jbuszkie/diyBMSv4/ModuleV450/export/PCB.pdf

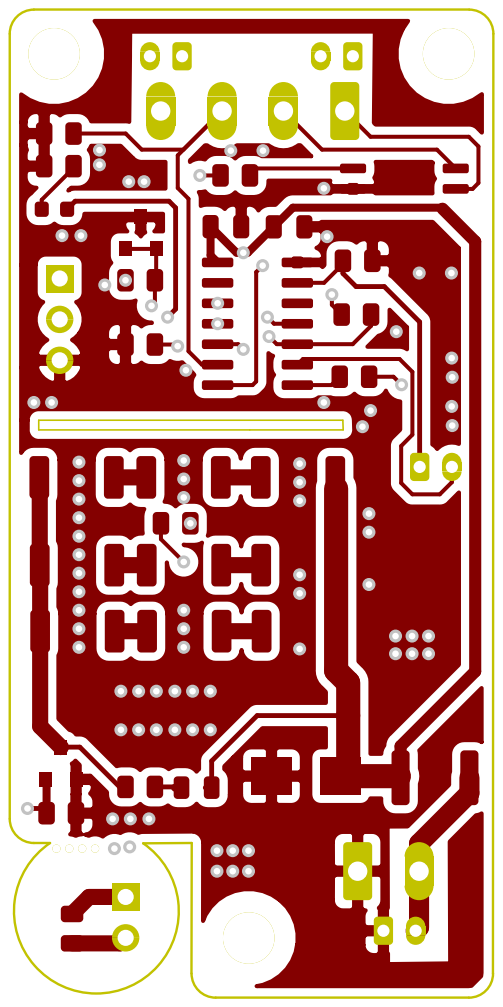
[picture p4: page 1]

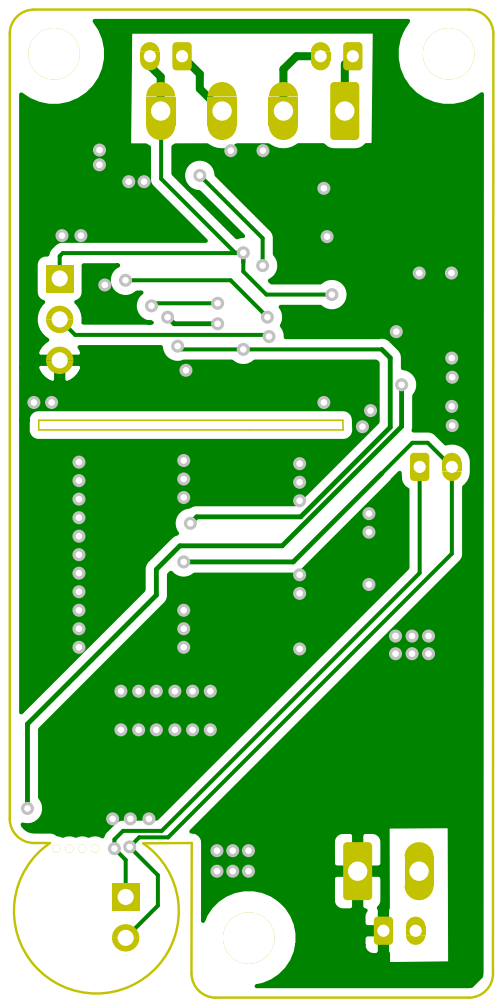
[picture p5: page 2]

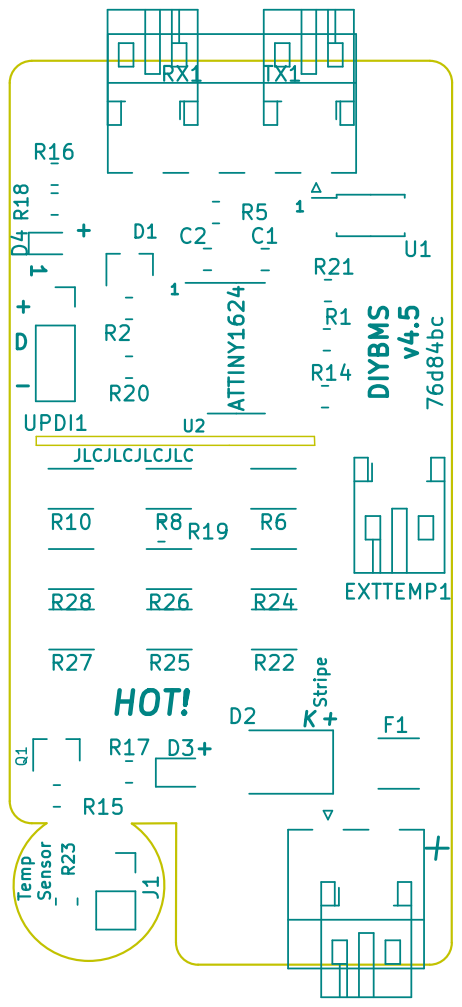
[picture p6: page 3]

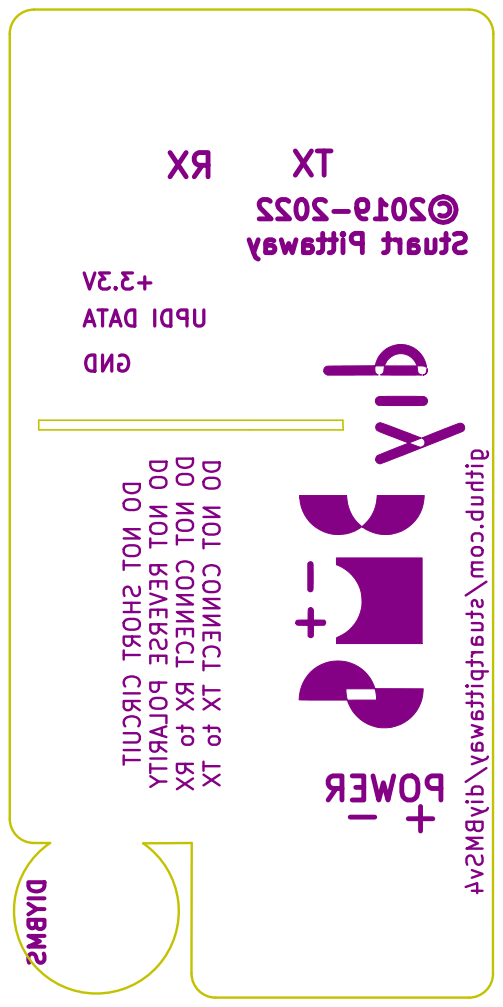
[picture p7: page 4]
