jbuszkie/diyBMSv4/ModuleV440JB/ModuleV440JB.kicad_pcb

## KiCad design ModuleV440JB/ModuleV440JB.kicad_pcb (2022-02-23)

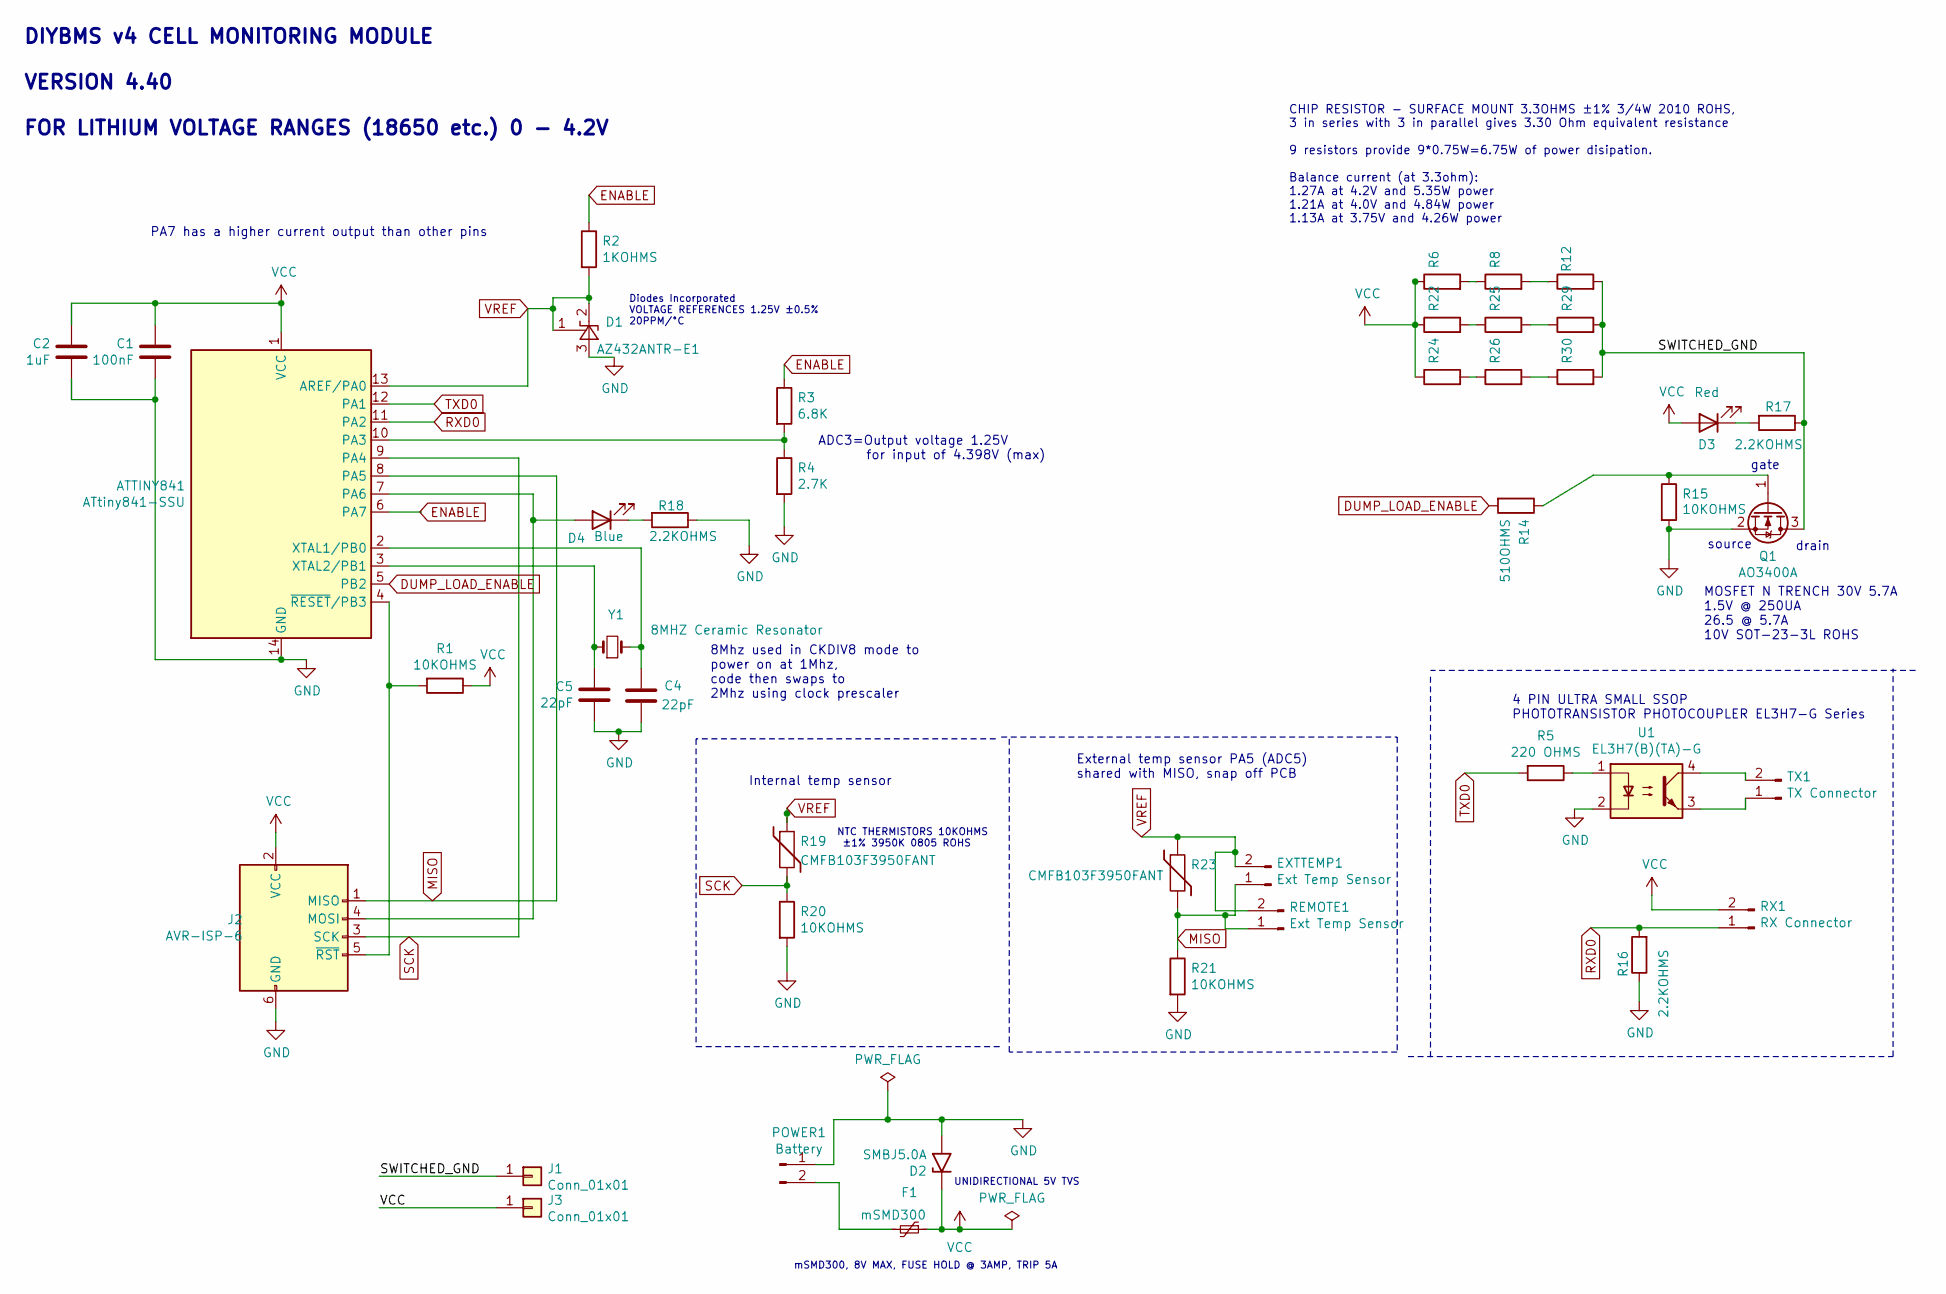
[picture p8: schematic ModuleV440JB.sch, DIYBMS cell monitoring module]

Parts:
ATTINY841: ATtiny841-SSU; SOIC-14_3.9x8.7mm_P1.27mm; LCSCStockCode C219103
C1: 100nF; C_0805_2012Metric; PartNumber CC0805KRX7R9BB104; LCSCStockCode C49678
C2: 1uF; C_0805_2012Metric; PartNumber CL21B105KBFNNNE; LCSCStockCode C28323
C4, C5: 22pF; C_0805_2012Metric; PartNumber CL21C220JBANNNC; LCSCStockCode C1804
D1: AZ432ANTR-E1; SOT-23; PartNumber AZ432ANTR-E1; LCSCStockCode C84139
D2: SMBJ5.0A; D_SMB; LCSCStockCode C440263
D3: Red; LED_0805_2012Metric; PartNumber 2012HRK-620D; LCSCStockCode C84256
D4: Blue; LED_0805_2012Metric; PartNumber Blue LED; LCSCStockCode C2293
EXTTEMP1: Ext Temp Sensor; JST_PH_S2B-PH-K_1x02_P2.00mm_Horizontal; PartNumber S2B-PH-K(LF)(SN); LCSCStockCode C265016
F1: mSMD300; Fuse_1812_4532Metric; PartNumber mSMD300; LCSCStockCode C69689
J1, J3: Conn_01x01; PinHeader_1x01_P2.54mm_Vertical
J2: AVR-ISP-6; Pin_Header_Straight_2x03_Pitch2.54mm; LCSCStockCode C65114
POWER1: Battery; JST_PH_S2B-PH-K_1x02_P2.00mm_Horizontal; PartNumber S2B-PH-K(LF)(SN); LCSCStockCode C265016
Q1: AO3400A; SOT-23; PartNumber AO3400A; LCSCStockCode C20917
R1, R15, R20, R21: 10KOHMS; R_0805_2012Metric; PartNumber 0805W8F1002T5E; LCSCStockCode C17414
R2: 1KOHMS; R_0805_2012Metric; PartNumber 0805W8F1001T5E; LCSCStockCode C17513
R3: 6.8K; R_0805_2012Metric; PartNumber 0805W8F6801T5E; LCSCStockCode C17772
R4: 2.7K; R_0805_2012Metric; PartNumber 0805W8F2701T5E; LCSCStockCode C17530
R5: 220 OHMS; R_0805_2012Metric; PartNumber 0805W8F2200T5E; LCSCStockCode C17557
R6, R8, R12, R22, R24, R25, R26, R29, R30: 3.3OHM 3/4W; R_2010_5025Metric; PartNumber 201007F330KT4E; LCSCStockCode C270971
R14: 510OHMS; R_0805_2012Metric; PartNumber 0805W8F5100T5E; LCSCStockCode C17734
R16, R17, R18: 2.2KOHMS; R_0805_2012Metric; PartNumber 0805W8F2201T5E; LCSCStockCode C17520
R19, R23: CMFB103F3950FANT; R_0805_2012Metric; PartNumber CMFB103F3950FANT; LCSCStockCode C51597
REMOTE1: Ext Temp Sensor; PinHeader_1x02_P2.54mm_Vertical
RX1: RX Connector; JST_PH_S2B-PH-K_1x02_P2.00mm_Horizontal; PartNumber S2B-PH-K(LF)(SN); LCSCStockCode C265016
TX1: TX Connector; JST_PH_S2B-PH-K_1x02_P2.00mm_Horizontal; PartNumber S2B-PH-K(LF)(SN); LCSCStockCode C265016
U1: EL3H7(B)(TA)-G; SOP-4_4.4x2.6mm_P1.27mm; PartNumber EL3H7(B)(TA)-G; LCSCStockCode C32565
Y1: 8MHZ Ceramic Resonator; Crystal_SMD_5032-2pin_5.0x3.2mm; PartNumber X50328MSB2GI; LCSCStockCode C115962

Connections:
/SWITCHED_GND: J1.1, Q1.3 (D), R12.2, R17.1, R29.2, R30.2
DUMP_LOAD_ENABLE: ATTINY841.5 (PB2), R14.2
ENABLE: ATTINY841.6 (PA7), R2.1, R3.1
GND: ATTINY841.14 (GND), C1.2, C2.2, C4.2, C5.2, D1.3 (A), D2.2 (A2), J2.6 (GND), POWER1.1, Q1.2 (S), R4.2, R15.2, R16.1, R18.1, R20.2, R21.2, U1.2
MISO: ATTINY841.8 (PA5), EXTTEMP1.1, J2.1 (MISO), R21.1, R23.2, REMOTE1.1
unnamed: ATTINY841.2 (XTAL1/PB0), C4.1, Y1.2
unnamed: ATTINY841.3 (XTAL2/PB1), C5.1, Y1.1
unnamed: ATTINY841.4 (~RESET~/PB3), J2.5 (~RST), R1.2
unnamed: ATTINY841.7 (PA6), D4.2 (A), J2.4 (MOSI)
unnamed: ATTINY841.10 (PA3), R3.2, R4.1
unnamed: D3.1 (K), R17.2
unnamed: D4.1 (K), R18.2
unnamed: F1.2, POWER1.2
unnamed: Q1.1 (G), R14.1, R15.1
unnamed: R5.1, U1.1
unnamed: R6.2, R8.1
unnamed: R8.2, R12.1
unnamed: R22.2, R25.1
unnamed: R24.2, R26.1
unnamed: R25.2, R29.1
unnamed: R26.2, R30.1
unnamed: TX1.1, U1.3
unnamed: TX1.2, U1.4
RXD0: ATTINY841.11 (PA2), R16.2, RX1.1
SCK: ATTINY841.9 (PA4), J2.3 (SCK), R19.2, R20.1
TXD0: ATTINY841.12 (PA1), R5.2
VCC: ATTINY841.1 (VCC), C1.1, C2.1, D2.1 (A1), D3.2 (A), F1.1, J2.2 (VCC), J3.1, R1.1, R6.1, R22.1, R24.1, RX1.2
VREF: ATTINY841.13 (AREF/PA0), D1.1 (FB), D1.2 (K), EXTTEMP1.2, R2.2, R19.1, R23.1, REMOTE1.2

Notes on the sheet:
PA7 has a higher current output than other pins
gate
source
drain
4 PIN ULTRA SMALL SSOP PHOTOTRANSISTOR PHOTOCOUPLER EL3H7-G Series
MOSFET N TRENCH 30V 5.7A 1.5V @ 250UA 26.5 @ 5.7A 10V SOT-23-3L ROHS
Diodes Incorporated VOLTAGE REFERENCES 1.25V ±0.5% 20PPM/°C
mSMD300, 8V MAX, FUSE HOLD @ 3AMP, TRIP 5A
External temp sensor PA5 (ADC5) shared with MISO, snap off PCB
NTC THERMISTORS 10KOHMS ±1% 3950K 0805 ROHS
ADC3=Output voltage 1.25V for input of 4.398V (max)
8Mhz used in CKDIV8 mode to power on at 1Mhz, code then swaps to 2Mhz using clock prescaler
DIYBMS v4 CELL MONITORING MODULE VERSION 4.40 FOR LITHIUM VOLTAGE RANGES (18650 etc.) 0 - 4.2V
Internal temp sensor
UNIDIRECTIONAL 5V TVS
CHIP RESISTOR - SURFACE MOUNT 3.3OHMS ±1% 3/4W 2010 ROHS, 3 in series with 3 in parallel gives 3.30 Ohm equivalent resistance 9 resistors provide 9*0.75W=6.75W of power disipation. Balance current (at 3.3ohm): 1.27A at 4.2V and 5.35W power 1.21A at 4.0V and 4.84W power 1.13A at 3.75V and 4.26W power

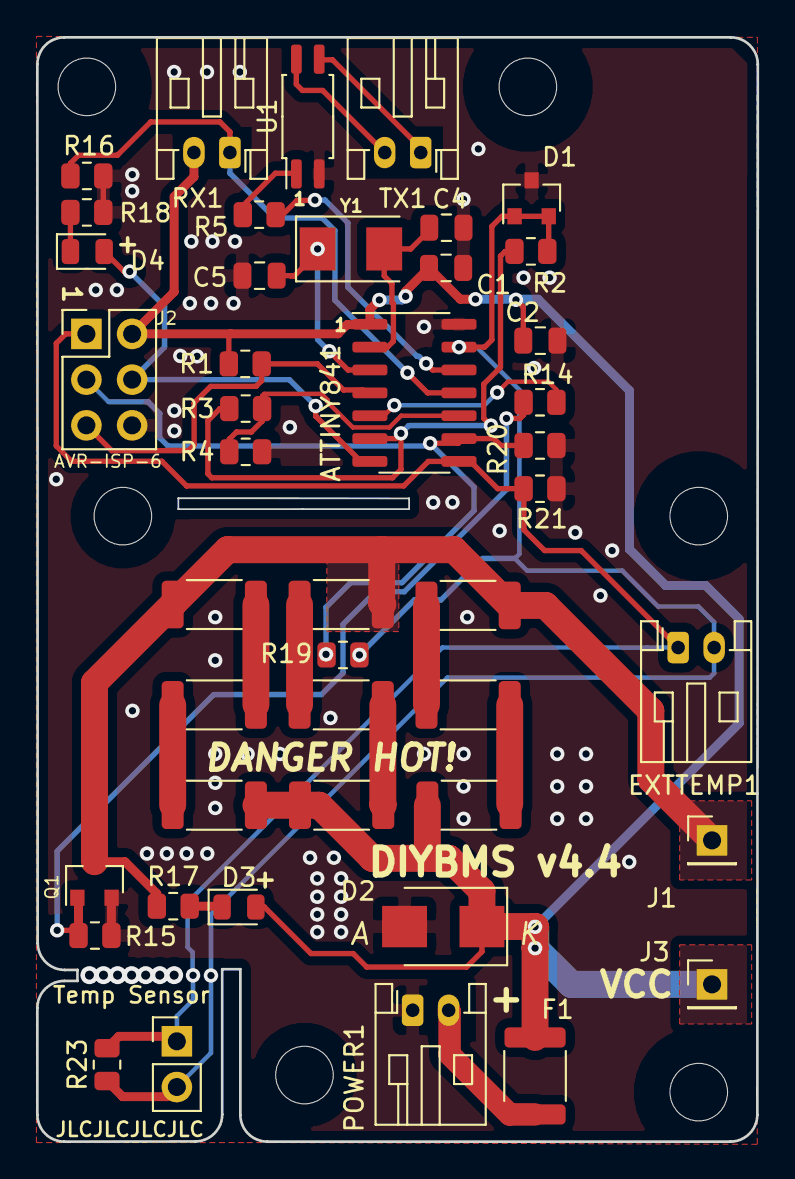
[picture p9: board ModuleV440JB.kicad_pcb from above]

Board: 2 copper layers, 40.0 x 61.3 mm, 44 parts (0 on the bottom side), 28 nets.
