jbuszkie/diyBMSv4/ControllerCircuit/ControllerCircuit.kicad_pcb

## KiCad design ControllerCircuit/ControllerCircuit.kicad_pcb (2022-02-23)

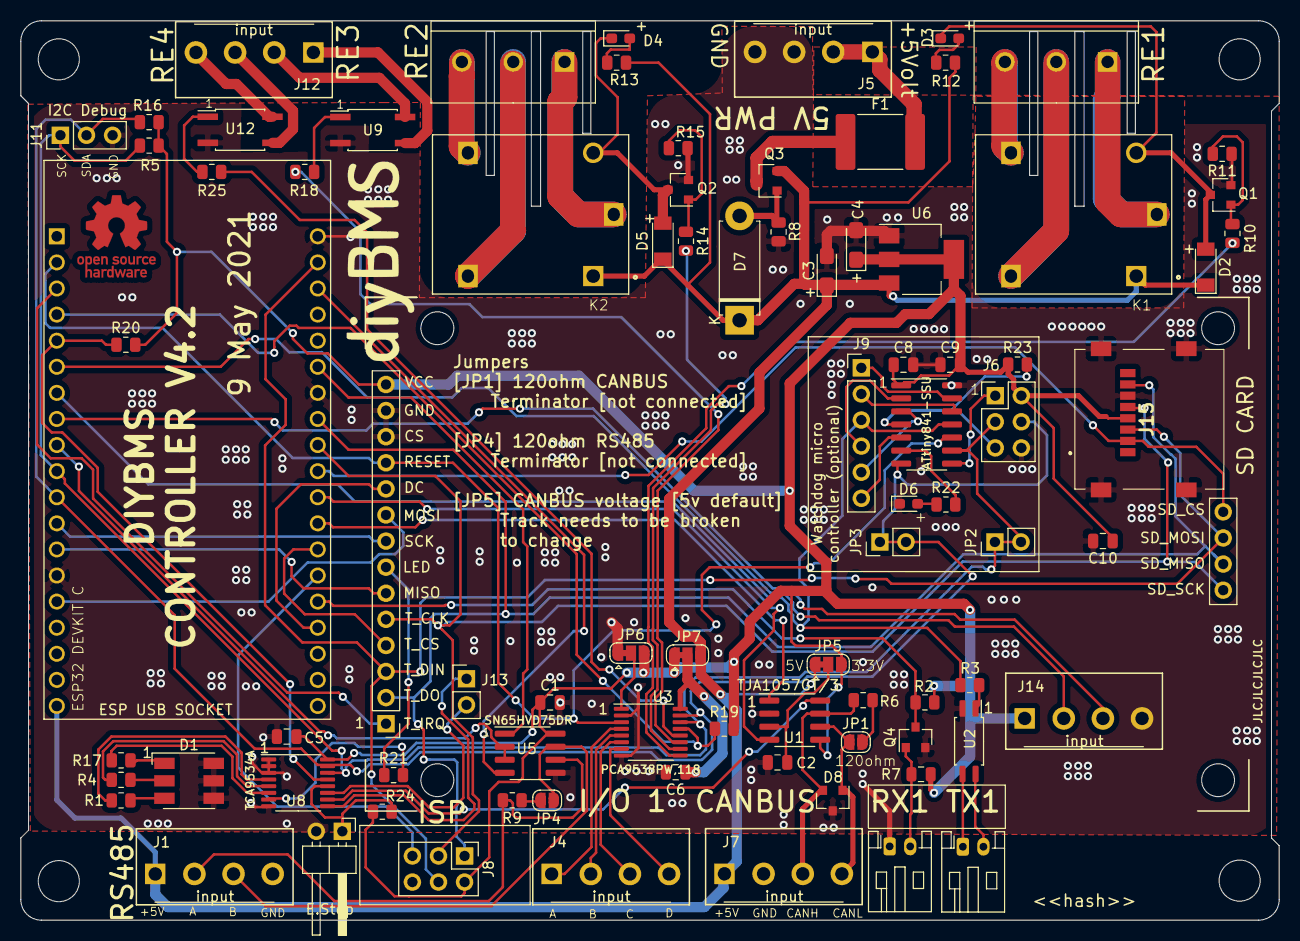
[picture p10: board ControllerCircuit.kicad_pcb from above]

Board: 2 copper layers, 122.5 x 87.5 mm, 84 parts (0 on the bottom side), 91 nets.

Parts:
C1, C2, C5, C6, C8: 100nF; C_0805_2012Metric
C3, C4: 22uF 6.3V; CP_EIA-3216-18_Kemet-A_Pad1.58x1.35mm_HandSolder
C9, C10: 1uF; C_0805_2012Metric
D1: RGB; LED_RGB_5050-6
D2, D5: LL4148; D_MiniMELF
D3, D4, D6: YELLOW LED; LED_0603_1608Metric_Pad1.05x0.95mm_HandSolder
D7: D_Zener_Small; D_5W_P10.16mm_Horizontal
D8: NUP2105LT1G; SOT-23
F1: Fuse, 1.85A; Fuse_2920_7451Metric
J1, J4, J5, J7, J12, J14: ScrewTerminal; Terminal-Block_3.81_4P_LCSC_C395880
J2, J3: ScrewTerminal3Pin; Terminal-Block_5.0mm_3P-LCSC_C395850
J6: AVR-ISP-6; PinHeader_2x03_P2.54mm_Vertical
J8: 2x3 2.54mm IDC Connectors; PinHeader_2x03_P2.54mm_Vertical
J9: Conn_01x06_Female; PinHeader_1x06_P2.54mm_Vertical
J10: Conn_01x02_Female; PinHeader_1x02_P2.54mm_Horizontal
J11: Conn_01x03_Female; PinHeader_1x03_P2.54mm_Vertical
J13: Conn_01x02_Female; PinHeader_1x02_P2.54mm_Vertical
J15: Molex 0472192001; 0472192001
JP1, JP4: OptTermination; SolderJumper-2_P1.3mm_Open_RoundedPad1.0x1.5mm
JP2, JP3: Conn_01x02_Female; PinHeader_1x02_P2.54mm_Vertical
JP5: CANBUS Volt Select; SolderJumper-3_P1.3mm_Bridged12_RoundedPad1.0x1.5mm
JP6: A0 Volt Select; SolderJumper-3_P1.3mm_Bridged12_RoundedPad1.0x1.5mm
JP7: I/O Volt Select; SolderJumper-3_P1.3mm_Bridged12_RoundedPad1.0x1.5mm
K1, K2: SRD-05VDC-SL-C; RELAY_SRD-05VDC-SL-C
LCD1: LCD; TFTSPI_2_8_240x320_TOUCH
Q1, Q2, Q4: AO3400A; SOT-23
Q3: AO3401A; SOT-23
R1, R8: 100R; R_0805_2012Metric
R2: 1M; R_0805_2012Metric
R3, R21, R22: 180R; R_0805_2012Metric
R4, R17: 300R; R_0805_2012Metric
R5, R7, R16: 2K2; R_0805_2012Metric
R6, R9: 120R; R_0805_2012Metric
R10, R14, R18, R25: 220R; R_0805_2012Metric
R11, R15, R19, R20, R23, R24: 10K; R_0805_2012Metric
R12, R13: 560R; R_0805_2012Metric
RX1: Receive; JST_PH_S2B-PH-K_1x02_P2.00mm_Horizontal
TX1: Transmit; JST_PH_S2B-PH-K_1x02_P2.00mm_Horizontal
U1: TJA1057GT/3; SOIC-8_3.9x4.9mm_P1.27mm
U2: EL3H7(B)(TA)-G; SOP-4_4.4x2.6mm_P1.27mm
U3: PCA9538PW,118; TSSOP-16_4.4x5mm_P0.65mm
U4: ESP32-DEVKITC-32D; MODULE_ESP32-DEVKITC-32D
U5: SN65HVD75DR; SOIC-8_3.9x4.9mm_P1.27mm
U6: AMS1117-3.3; SOT-223-3_TabPin2
U8: TCA9534A; TSSOP-16_4.4x5mm_P0.65mm
U9, U12: AQY212GSZ; SO-4_4.4x3.6mm_P2.54mm
U10: ATtiny841-SSU; SOIC-14_3.9x8.7mm_P1.27mm

Connections:
+3V3: C1.1, C4.1, C5.2, C8.1, C9.2, C10.1, J6.2, J8.2, J14.1, J15.4, JP5.3, JP6.3, JP7.1, LCD1.14, R2.2, R5.2, R7.1, R16.2, R19.2, R20.2, R23.1, R24.2, U1.5, U5.8, U6.2, U8.16, U10.1
+5V: F1.2, J5.1, J5.2
/AVRISP_RESET: J8.5, U4.33
/BLUE_LED: R1.2, U8.4
/CANBUS_RX: U1.4, U4.30
/CANBUS_S: U1.8, U8.10
/CANBUS_TX: U1.1, U4.31
/DISPLAY_DC: LCD1.10, U4.35
/DISPLAY_LED: R21.2, U8.7
/EXT_IO_A: J4.1, U3.4
/EXT_IO_B: J4.2, U3.5
/EXT_IO_C: J4.3, U3.6
/EXT_IO_D: J4.4, U3.7
/GREEN_LED: R17.2, U8.6
/HSPI_CLK: LCD1.8, U4.12
/HSPI_MISO: LCD1.6, U4.13
/HSPI_MOSI: LCD1.9, U4.15
/IO2: Q4.3, R2.1, U4.34
/IO4: LCD1.4, U4.32
/IO5: J15.2, LCD1.SD4, U4.29
/IO21: U4.25, U5.1
/IO22: U4.22, U5.4
/IO25: U4.9, U5.2, U5.3
/IO26: J6.3, J11.1, JP2.1, JP2.2, R5.1, U3.14, U4.10, U8.14, U10.9
/IO27: J6.4, J11.2, JP3.1, JP3.2, R16.1, U3.15, U4.11, U8.15, U10.7
/IO32: J9.3, R3.2, U4.7, U10.11
/IO33: J14.3, U4.8
/IO34_INPUT: R20.1, U4.5, U8.13
/IO35_INPUT: J14.2, U4.6
/IO36_INPUT: LCD1.1, U4.3
/IO39_INPUT: R19.1, U3.13, U4.4
/RED_LED: R4.2, U8.5
/RELAY1: R10.2, U3.9
/RELAY2: R14.2, U3.10
/RELAY3_SSR: R18.2, U3.11
/RELAY4_SSR: R25.2, U3.12
/RESET: LCD1.11, U3.3, U4.2, U10.10
/U3_PWR: C6.1, JP7.2, U3.16
/VSPI_CLK: J8.3, J15.5, LCD1.5, LCD1.SD1, U4.28
/VSPI_MISO: J8.1, J15.7, LCD1.2, LCD1.SD2, U4.27
/VSPI_MOSI: J8.4, J15.3, LCD1.3, LCD1.SD3, U4.21
FUSED5V: C3.1, D2.1, D5.1, D7.1, J1.1, J7.1, JP5.1, JP7.3, K1.A1, K2.A1, Q3.2, R12.2, R13.2, U4.19, U6.3
GND: C1.2, C2.2, C3.2, C4.2, C5.1, C6.2, C8.2, C9.1, C10.2, D1.4, D1.5, D1.6, D6.1, D8.3, J1.4, J5.3, J5.4, J6.6, J7.2, J8.6, J10.2, J11.3, J14.4, J15.6, J15.G1, J15.G2, J15.G3, J15.G4, JP6.1, LCD1.12, LCD1.13, Q1.2, Q2.2, Q4.2, R8.2, R11.1, R15.1, RX1.1, U1.2, U2.2, U3.2, U3.8, U4.14, U4.20, U4.26, U5.5, U6.1, U8.1, U8.2, U8.3, U8.8, U9.2, U10.14, U12.2
unnamed: C2.1, JP5.2, U1.3
unnamed: D1.1, R17.1
unnamed: D1.2, R4.1
unnamed: D1.3, R1.1
unnamed: D2.2, D3.1, K1.A2, Q1.3
unnamed: D3.2, R12.1
unnamed: D4.1, D5.2, K2.A2, Q2.3
unnamed: D4.2, R13.1
unnamed: D6.2, R22.1
unnamed: D7.2, Q3.1, R8.1
unnamed: D8.1, J7.4, JP1.1, U1.6
unnamed: D8.2, J7.3, R6.2, U1.7
unnamed: F1.1, Q3.3
unnamed: J1.2, R9.1, U5.6
unnamed: J1.3, JP4.1, U5.7
unnamed: J2.1, K1.COM
unnamed: J2.2, K1.NC
unnamed: J2.3, K1.NO
unnamed: J3.1, K2.COM
unnamed: J3.2, K2.NC
unnamed: J3.3, K2.NO
unnamed: J6.1, U10.8
unnamed: J6.5, R23.2, U10.4
unnamed: J9.1, U10.13
unnamed: J9.2, U10.12
unnamed: J9.4, U10.2
unnamed: J9.5, U10.3
unnamed: J9.6, U10.5
unnamed: J10.1, R24.1, U8.12
unnamed: J12.1, U9.3
unnamed: J12.2, U9.4
unnamed: J12.3, U12.3
unnamed: J12.4, U12.4
unnamed: J13.1, U8.9
unnamed: J13.2, U8.11
unnamed: JP1.2, R6.1
unnamed: JP4.2, R9.2
unnamed: JP6.2, U3.1
unnamed: LCD1.7, R21.1
unnamed: Q1.1, R10.1, R11.2
unnamed: Q2.1, R14.1, R15.2
unnamed: Q4.1, R7.2, RX1.2
unnamed: R3.1, U2.1
unnamed: R18.1, U9.1
unnamed: R22.2, U10.6
unnamed: R25.1, U12.1
unnamed: TX1.1, U2.3
unnamed: TX1.2, U2.4
