jbuszkie/diyBMSv4/(commit log)

2022-02-23 test commit
    [ControllerCircuit-B_Cu.gbr, ControllerCircuit-B_Mask.gbr, ControllerCircuit-B_Paste.gbr, ControllerCircuit-B_SilkS.gbr, ControllerCircuit-Edge_Cuts.gbr, ControllerCircuit-F_Cu.gbr, ControllerCircuit-F_Mask.gbr, ControllerCircuit-F_Paste.gbr]
2022-02-23 Add new directory
    [ModuleV440JB.kicad_pcb, ModuleV440JB.sch]
2022-12-15 CI: pcb-artifacts-module450
    [ModuleV450-drill.drl, ModuleV450.GBL, ModuleV450.GBO, ModuleV450.GBS, ModuleV450.GKO, ModuleV450.GTL, ModuleV450.GTO, ModuleV450.GTS]
