jbuszkie/diyBMSv4/(notices)

Notices in the files:
ControllerCircuit/ControllerCircuit.kicad_pcb:
©2019 to 2021 Stuart Pittaway
ControllerCircuit/ControllerCircuit.sch:
This work is licensed under a Creative Commons Attribution-NonCommercial-ShareAlike 2.0 UK: England & Wales License.
https://creativecommons.org/licenses/by-nc-sa/2.0/uk
ModuleV440JB/ModuleV440JB.kicad_pcb:
©2019-2021
